anirban185/Anirban-s-Bicycle-Taillight/(list of files, drawings)

Other design files:
Hardware/Altium/Schematic.schdoc
