anirban185/Anirban-s-Bicycle-Taillight/(commit log)

2026-09-03 Add BOM.csv
    [BOM.csv]
2026-09-05 Add Schematic.schdoc
    [Schematic.schdoc]
